PaulinaGOC/Cleaner-Robot/(list of files, cad)

Other CAD files:
CAT Parts/Base_suelo.CATPart
CAT Parts/Cajon.CATPart
CAT Parts/Soporte_base.CATPart
